gregorywright/printer-stand/SHOPPING.md

# Shopping List — Parts & Consumables

Everything that gets *consumed* by the build — steel, hardware, paint,
fasteners. Tools and PPE are in `TOOLS.md`.

The two SCAD variants share most of this list. The only difference is
the back bracing:
- **Cable-X variant** (`printer_stand.scad`) uses tensioned aircraft cable
- **Z-back variant** (`printer_stand_zback.scad`) uses two welded tube
  diagonals, which come out of the same tube stock as the rest of the frame

So the **steel order is the same for both variants** (3 sticks of tube
covers either one). Only the cable hardware differs.

Items checked are already on hand or already ordered.

---

## Steel stock (both variants)

- [ ] **1.5"×1.5"×0.120" wall A500 square tube** — buy **3× 20-ft sticks** (~60 ft)
  - Used on: legs, end-frame horizontals, end-frame diagonals, long stretchers, plus the back-panel diagonals on the Z-back variant
  - ~52.4 ft used, rest is waste/practice margin
- [ ] **3/4"×3/4"×1/8" mild steel angle** — buy **1× 20-ft stick** (~20 ft)
  - Used on: 4 angle-iron ledgers, 39.875" each (~13.3 ft used)
- [ ] **1.5"-wide × 3/8" flat bar** — buy **7 ft**
  - Cut to 5" lengths for plate A (12 plates = 5 ft), plus 4 × 1.5" foot-cap
    plates for the leg ends (~6") — buying 7 ft covers both with margin
  - Tip: buy *flat bar* in the exact width you need. Way cheaper than
    cutting plates out of sheet.
- [ ] **1.5"-wide × 3/16" flat bar** — buy **6 ft**
  - Cut to 5" lengths for plate B (12 plates needed)

**Where to buy:** Pacific Industrial Supply (Seattle — weekday pickup only).
Sold by the pound; full-length sticks. **Avoid Home Depot / Metals Depot /
eBay** — typically 50–100% more expensive on tube.

**Pricing (Pacific Industrial Supply):**

| Stock | $/lb | $/ft | Buy | Cost |
|---|---|---|---|---|
| 1.5×1.5×0.120 tube (2.25 lb/ft) | $2.30 | $5.18 | 60 ft (3×20') | **$311** |
| 3/4×3/4×1/8 angle (0.58 lb/ft) | ~$2.30¹ | ~$1.35¹ | 20 ft (1×20') | **~$27**¹ |
| 1.5"×3/8" flat bar (1.92 lb/ft) | $1.75 | $3.36 | 7 ft | **$23** |
| 1.5"×3/16" flat bar (0.96 lb/ft) | $1.75 | $1.68 | 6 ft | **$10** |
| **Steel subtotal** | | | | **~$371** |

¹ Angle iron price not yet confirmed — estimated at the same $/lb as tube.

---

## Practice stock (skills warm-up — NOT part of the build)

Grab these as cheap **drops/remnants** (sold by the pound) on the same steel-
yard trip, to practice welding, cutting, and tapping before you touch the
real sticks. Skill-building only — we are **not** switching the build to
thinner tube (see `DESIGN.md`).

- [ ] **1.5"×1.5"×0.120" tube** — ~8–12 ft of drops. Cut into ~4–6" coupons
  for 90° corner/T joints and **45° miters**, and to dial in heat on your
  REAL wall thickness (the key burn-through calibration).
- [ ] **14ga square tube** (~0.065–0.083" wall) — ~6 ft. "Hard mode" heat
  control: if you can weld this without blowing through, 0.120" feels easy.
  Practice only; confirm the actual wall when buying.
- [ ] **3/8" flat bar, 1.5" wide** — ~2 ft. Tap **3/8"-16** (plate A) and
  **M12×1.75** (foot-cap), and practice the **3/8"-plate-to-tube fillet** (the
  hardest real weld) + capping a tube end. Buy extra so you can afford to
  break a tap.
- [ ] **3/16" flat bar, 1.5" wide** — ~1.5 ft. Drill 7/16" clearance holes;
  weld plate B to a tube END; cut + **edge-weld a cable-anchor tab** and drill
  its hole.
- [x] **3/4"×3/4"×1/8" angle** — already have ~3 ft. Practice welding thin
  angle to tube + drilling the shelf-screw holes.

**At the yard:** use the drop rack; bring a **magnet** (mild steel only —
skip galvanized/painted/oily); match the build wall (**0.120"**) for the
calibration coupons. Already on hand: taps (metric + imperial), tap drills,
and cutting fluid.

---

## Welding consumables (both variants)

- [ ] **Flux-core wire**, E71T-11, 0.030" diameter, **2-lb spool**
  - 10-lb spool is more economical if you'll do future projects
- [x] Anti-spatter nozzle dip (already have)
- [ ] Anti-spatter spray (different product — protects the workpiece;
  optional, makes cleanup faster but not required)

---

## Hardware — flange-plate joints (both variants)

- [ ] **3/8"-16 × 1" hex bolts**, qty **30** (24 needed + spares)
  - Grade 5 zinc-plated *or* 18-8 stainless are both fine. Stainless
    looks cleaner and won't rust; grade 5 is a touch stronger if it
    matters (it doesn't, here).
  - If using stainless: lubricate threads on assembly to prevent galling
- [ ] **3/8" flat washers**, qty 30 — one per bolt under the head

---

## Hardware — leveling feet (both variants)

- [x] **M12×1.75 swivel leveling feet**, 2" (50mm) rubber base, 50mm stud,
  qty **4** (Luomorgo or similar). Rubber/nylon base doubles as the floor
  pad. Confirm pitch is **M12×1.75** (coarse) so a standard M12 tap fits.
- [ ] **Make your own foot-cap plates**: 4 × 1.5"×1.5"×3/8" steel squares,
  welded onto the leg ends (cap), then tapped M12×1.75 for the leveler studs
  - Cut from the 3/8" flat-bar offcut (see Steel stock) — no extra material
  - **M12×1.75 tap + ~10.2mm (13/32") drill** does the tapping (tool — see `TOOLS.md`)

---

## Hardware — wood top mounting (both variants)

- [ ] **3/8"-16 threaded inserts for wood** (E-Z Lok or knife-thread), qty **4–8**
- [ ] **3/8"-16 × 1" pan-head machine screws**, qty 4–8 (match insert count)
- [ ] **1" fender washers**, qty 4–8 — big OD to span the slotted holes

---

## Back bracing — open-back build (current plan)

The current plan builds the back **open** (no cable X, no Z-tube) and adds
the cable X later *only if* post-build testing shows wobble (see `DESIGN.md`).
That splits this into two buys: the **anchors** (made/welded now, part of the
base build) and the **cable chain** (deferred).

### Anchors — fabricate & weld during initial build

- [ ] **4 cable anchors** on the rear corner legs. Either:
  - **DIY (≈$0):** cut from the 3/16" flat-bar offcut, ~3/4–1" wide, drill a
    hole for a 1/4" shackle pin, **edge-weld so the hole stands clear of the
    tube** (a hole in a tab laid flat against the tube is blocked). OR
  - **Buy (~$10–20):** weld-on pad eye or weld-on D-ring (search "weld on pad
    eye" or "weld on D ring tie down"), qty 4. Trailer-rated ones are wildly
    overkill; grind off any zinc plating before flux-core welding.
- Load is trivial — size for looks/weldability, not strength. No swivel
  needed (the shackle articulates). **Weld these on *before* paint/powder**
  so adding cables later needs no welding.

### Cable chain — deferred (buy only if testing shows wobble)

Skip unless/until you decide to install the X-wing.

- [ ] **1/8" stainless 7×19 aircraft cable**, ~12 ft (two diagonals + overhead)
- [ ] **Cable eye terminals**, stainless, qty **4** — mechanical/swageless
  (e.g. Hayn Hi-MOD, no swage tool needed) or swaged eyes
- [ ] **Stainless turnbuckles**, jaw-and-jaw, 1/4" stock, qty **2**
- [ ] **Stainless shackles**, ~1/4" pin, qty **2** — connect each cable's
  non-turnbuckle end to its anchor
- [ ] *(Optional)* cable cutter — borrow if possible (see `TOOLS.md`)

**Deferred cable-chain subtotal:** ~$80–$120

---

## Z-back variant ONLY (`printer_stand_zback.scad`)

**No additional parts.** The two back-panel diagonals come out of the
3 sticks of tube already counted above. This variant is ~$80–$120 cheaper
than the cable variant (no cable hardware to buy).

---

## Finishing (both variants)

Pick one path:

**DIY rattle-can** (~$50)
- [ ] Acetone or denatured alcohol (degrease before painting)
- [ ] Self-etching primer for steel, 1 can
- [ ] Matte/satin black enamel top coat, 2–3 cans

**Powder coat** (~$100–200, recommended for durability)
- [ ] Drop the disassembled frame at a local powder coater. Disassemble
  first — the powder coater bakes the parts in an oven and they need to
  fit in racks.

---

## Floor protection (both variants)

- Not needed — the M12 leveling feet have rubber/nylon bases that protect
  the tile and resist creep. (Add felt pads only if you switch to bare-steel feet.)

---

## Cost rollup

| Category | Cost |
|---|---|
| Steel stock (Pacific Industrial) | ~$371 |
| Welding consumables | ~$15 |
| Bolts + washers | ~$15 |
| Levelers + M12 tap | ~$40 |
| Wood-top mounting hardware | ~$10 |
| Back-brace anchors (welded at fab) | ~$0–20 |
| Finishing (DIY rattle-can) | ~$50 |
| Floor pads | $0 (rubber-base feet) |
| **Base build (open back)** | **~$500** |
| Cable X chain (*deferred* add-on, only if needed) | +$80–$120 |

If powder-coating instead of rattle-can, add ~$100.

---

## Wood (you have this)

- [x] Hardwood for the top, ~48"×25.75"×**1-3/16"** (matches the adjacent
  counter). Red oak / white oak / hard maple — hard enough not to dent in
  light bench use. Plane to final thickness after measuring the built frame.
- [x] Plywood for the two shelves: cut to fit after the frame is built
  (from one 4'×8' sheet of 3/4" plywood)
