gregorywright/printer-stand/(list of files, cad)

Other CAD files:
printer_stand_zback.scad
