gregorywright/printer-stand/(commit log)

2026-05-25 Initial design: knockdown steel + wood 3D printer stand
    OpenSCAD model plus design docs for a welded-steel-frame, bolt-together
    3D printer stand sized to match an adjacent kitchen counter (37" tall,
    48"x25.75" top). Uses two welded end frames, six bolted long stretchers
    with flange-plate joints, internal end-frame diagonals, top knee braces,
    and a tensioned cable X across the back.
    [printer_stand.scad]
2026-05-25 Refine flange plate geometry and shelf heights
    Replace 3"x3" flange plates with tall narrow columns (1.5"W x 6"H) aligned
    with leg face — no Y-axis protrusion, ~2x moment resistance for shelf loads.
    Plates are asymmetric: 3/8" tapped plate A on the leg, 3/16" clearance
    plate B on the stretcher end. Bolts thread directly into plate A; no
    separate nuts.
    Raise middle shelf to 23.75" for 10" upper-bay clearance and 17.25" lower-bay
    clearance (fits 8" filament spools standing up). Lower-bay diagonal now runs
    at ~42.6°.
    Resolve knee-brace knockdown problem: braces weld between plate B's lower
    extension and stretcher tube underside, traveling with the stretcher
    assembly.
    [printer_stand.scad]
2026-05-25 Simplify joints to 2 bolts, add angle-iron shelf ledgers, fix knee brace
    Drop bolts per joint from 4 to 2 (24 bolts total instead of 48). Originally
    overbuilt by ~50x; 2 bolts at +/-1.75" from stretcher centerline still gives
    huge margin and resolves the bolt-tube collision on middle/bottom plates.
    Differentiate plate heights by stretcher position. Top stretchers need 7.5"
    to fit tube + 2 bolts + knee brace with socket-wrench clearance. Middle/
    bottom need only 5" (tube centered, one bolt above and below).
    Render knee braces with proper mitered cuts: outboard end vertical (flush
    to plate B), inboard end horizontal (flush to stretcher underside).
    Add 3/4"x3/4"x1/8" angle-iron ledgers welde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
    [printer_stand.scad]
2026-05-25 Fix knee brace orientation and top-stretcher bolt placement
    Knee braces were rendered in the wrong plane: polygon() lives in XY but the
    brace silhouette uses XZ coordinates, so the Z values got interpreted as Y
    and the braces floated 30" behind the stand. Add rotate([90,0,0]) before
    linear_extrude so the polygon's Y axis maps to world Z.
    Top-stretcher bolts: previous symmetric bolt placement put one bolt at
    z=36.25" -- inside the wood top, hidden. Both top-stretcher bolts now sit
    below the tube (z=33.0 and z=31.5), in the gap between tube bottom and
    knee-brace top, with 1.5" socket clearance. Middle/bottom stretchers still
    straddle the tube symmetrically.
    [printer_stand.scad]
2026-05-25 Drop knee braces, unify plate height to 5"
    Knee braces were structurally redundant given welded rectangular corners,
    end-frame diagonals, cable X, and the moment resistance of the 2-bolt
    flange joints (1.5" lever arm between top-joint bolts gives ~50:1 safety
    factor against top-joint racking). Removing them simplifies fabrication
    and lets every flange plate be the same size.
    All 12 plates now 1.5"x5" (was 7.5" for top stretchers, 5" for others).
    Top-stretcher plates still have their tube at the top edge with both bolts
    below; middle/bottom plates still center on the stretcher with one bolt
    above and one below. No change to bolt count, ledgers, cable X, or
    end-frame geometry.
    [printer_stand.scad]
2026-05-25 Add Z-tube back-panel variant alongside cable-X version
    New printer_stand_zback.scad: identical to printer_stand.scad except the
    cable X on the back is replaced by two welded tube diagonals in a Z
    pattern (upper-bay slope \, lower-bay slope /). The three back-stretchers
    plus two diagonals form a pre-welded "back panel" that bolts to the legs
    through the existing six plate-pair joints. No cable hardware required.
    Owner is keeping both designs to compare visually before picking. Update
    AGENTS.md to require future upstream changes (legs, end frames, stretchers,
    plates, ledgers, shelves, top) to be applied to BOTH SCAD files. Note the
    variant in DESIGN.md.
    [printer_stand_zback.scad]
2026-05-25 Add tools and supplies catalog
    New TOOLS.md catalogs everything needed for the build with checkboxes:
    welding, cutting/grinding, drilling/tapping, measuring, hand tools,
    woodworking, steel stock, hardware, wood-top mounting, cable hardware
    (cable-X variant only), finishing, floor protection, PPE.
    Items the owner already has are checked. Unchecked items are still on
    the shopping list. Approximate cost rollup for the unchecked items at
    the bottom (~$1,000-1,400 if starting from nothing).
    Reference TOOLS.md from AGENTS.md.
2026-05-26 Split parts/consumables out of TOOLS.md into SHOPPING.md
    New SHOPPING.md catalogs everything that gets consumed by the build
    (steel stock, welding consumables, hardware, finishing, floor pads),
    broken out by variant. Steel order is identical for both variants;
    only the cable hardware differs. Includes cost rollup: cable-X variant
    ~$455-$655, Z-back variant ~$375-$535.
    TOOLS.md now scoped to tools and PPE only -- the parts duplications
    removed.
2026-05-28 Remove fabricated McMaster part numbers
    The "McMaster 2417K3" and "McMaster 91833A132" part numbers in SHOPPING.md
    were not real -- they were invented as plausible-looking placeholders.
    Replaced with actual search instructions (category names + filter criteria)
    plus an Amazon alternative for each, and a note distinguishing weld-in
    inserts from rivnuts.
2026-05-31 Design update: 45° end-frame diagonal, split overhangs, 1-3/16" wood top, tapped foot-cap feet
    - End-frame diagonal: true 45°, single-miter, back-top to front-bottom
    (modeled as a real mitered solid, not a square-cut tube_between)
    - Overhangs split into independent sides (OVERHANG_LR) and front/back
    (OVERHANG_FB), both default 2"
    - Wood top thickness -> 1-3/16" (matches counter); steel top now 35.8125";
    wood top re-added to the SCAD render (plywood shelves still not modeled,
    ledgers kept)
    - Leveler feet: tapped 3/8" foot-cap plate (1/2"-13) welded on leg ends,
    replacing the weld-in insert; legs cut long and trimmed to fit; nominal
    lift set mid-range (~1") for two-way error take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
    [printer_stand.scad, printer_stand_zback.scad]
2026-05-31 Moved to metric, M12, leveling feet
    [printer_stand.scad, printer_stand_zback.scad]
2026-06-01 Add weld-on cable anchors + wood-top hold-downs; defer rear cable X
    Design decision: build the back open (no cable X / Z-tube), keep the
    end-frame diagonals, test, and add the cable X later only if it wobbles.
    Weld the 4 cable anchors at fabrication so adding cables later is a
    no-welding bolt-on job.
    SCAD (both files kept in sync upstream of the back face):
    - Model wood-top hold-down clips on the top stretchers (front-center =
    fixed round-hole anchor, rest Y-slotted) + fender washer/screw.
    - printer_stand.scad: add 4 weld-on cable anchors (always shown); route
    cable X to the anchor holes; add SHOW_CABLES toggle (cables deferred)
    and SHOW_WOOD_MOUNTS.
    - Cut lists updated.
    Docs: SPECS/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
    [printer_stand.scad, printer_stand_zback.scad]
2026-06-01 Fix angle-ledger placement (was buried in tube); add per-part colors
    - angle_ledger: corrected so the angle sits on the inboard top edge and
    projects inward (was computing the outboard face and landing the legs
    fully inside the stretcher tube -> invisible on F6). Verified visible
    via OpenSCAD render.
    - Colors: square tube stays steel-grey; every non-tube part now has its
    own contrasting color (plate A blue, plate B amber, ledgers green,
    wood clips purple, cable anchors red) so joints read clearly.
    - Both files render manifold, NoError.
    [printer_stand.scad, printer_stand_zback.scad]
2026-06-01 Correct wood-movement spec: Seattle swing + fix too-short slot length
    - DESIGN.md: add the cross-grain movement calc (species table @ ΔMC 4),
    note Seattle's small ~ΔMC 3-4 indoor swing (~1/4-3/8" full-width oak),
    fix the slot spec (was "~3/8 long" = ~zero travel) to ~15/16" matching
    the SCAD model, and correct the anchor description (front-anchored top
    floats toward the back, not symmetric).
    - SPECS.md: update the wood-movement constraint with the Seattle estimate
    and a pointer to the calc.
2026-06-01 Inset shelf ledgers by plywood thickness; screw-down hold-down
    - angle_ledger: recess the support leg DOWN by the plywood thickness
    (PLY_THK = 23/32") so the plywood TOP finishes flush with the stretcher
    tube top (was flush AT the top, leaving the ply proud). Add wood-screw
    clearance holes through the horizontal leg every ~6" (SHELF_SCREW_PITCH)
    -- plywood is dimensionally stable so round holes, no slots. Ledgers stay
    full-length. Both SCAD files in sync; render manifold NoError.
    - Docs (SPECS/DESIGN/AGENTS): ledger inset, full-length span, and screwed-
    down (not gravity-held) plywood.
    [printer_stand.scad, printer_stand_zback.scad]
2026-06-01 SHOPPING: add practice-stock section (welding/tapping warm-up)
    Skill-building scraps for the steel-yard trip: 0.120" tube coupons,
    14ga tube (heat-control practice only, not a build switch), 3/8" and
    3/16" flat bar for tap/fillet practice; notes the 1/8" angle already on
    hand and the yard tips (drop rack, magnet, no galvanized).
2026-06-02 Model the welded leg-end foot-cap plate at each foot
    - Draw the 1.5x1.5x3/8 foot-cap (FOOTCAP_THK, teal) between the leg-tube
    bottom and the leveler stud, and trim the stud to the cap underside (it
    was drawn through the cap's space). The cap's 3/8 was already inside the
    1.75 LEVELER_HT lift, so total height is unchanged.
    - DESIGN.md: make the foot-cap explicit in the nominal-lift stack.
    - Both SCAD files in sync; render manifold NoError.
    [printer_stand.scad, printer_stand_zback.scad]
2026-06-02 Record out-of-level floor; level with feet only (keep end-frames identical)
    Floor drops ~1/2" over the 48" width (~0.44" across the 42.5" foot span).
    Handled entirely by the adjustable leveler feet (only ~0.22" centered, well
    within travel). Do NOT trim legs to a floor's slope: the stand is knockdown
    and relocatable, and the end-frames are built identical -- re-level the feet
    at each location. No SCAD change.
2026-06-02 Set leveler nominal to 2.0" (cap stacks above leveler); leg -> 33.4375"
    Real foot measures 42-72mm (floor->cap underside) and the install floor
    slopes ~1/2" down away from the counter, so the far feet ride ~1/2" higher
    than the counter feet (a fixed offset). Center that foot PAIR in the range:
    counter-end foot ~2.0", far-end ~2.5", leaving ~+/-0.34" build slack and
    keeping the far foot under the 72mm max. (2.25" range-center would top out
    the far foot.)
    - SCAD (both): LEVELER_HT 1.75->2.0 (= leveler hardware only, floor->cap
    underside); LEG_BOTTOM_Z = LEVELER_HT + FOOTCAP_THK (cap stacks ABOVE the
    leveler); LEG_HT recomputes to 33.4375"; comments + cut list updated.
    Total height uncha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
    [printer_stand.scad, printer_stand_zback.scad]
2026-06-02 Update SHOPPING.md with Pacific Industrial Supply pricing
    - Add actual $/lb rates: tube .30/lb, flat bar .75/lb
    - Calculate per-foot costs and line-item totals
    - Angle iron estimated with footnote (not yet confirmed)
    - Simplify cost rollup to single column (~00 base build)
2026-06-08 Add EXTRUSIONS.md and FABRICATION.md; index in AGENTS.md
    - EXTRUSIONS.md: pros/cons catalog of a T-slot aluminum (4040/4080)
    alternative, with a how-it-works primer and a calculated check showing the
    A1 bed (~2-5 lbf) is well below the fastener slip threshold (won't loosen
    T-nuts) — corrects an earlier overstated claim.
    - FABRICATION.md: build/bench guide — flat reference surface, wooden
    end-frame jig (+ owner's magnetic squares), 3-faces-then-flip weld access,
    balanced skip-weld sequence, clamp-force reality (~100 lbf positioning, not
    restraint), welding-near-wood precautions, and 9-step build order.
    - AGENTS.md: index both new files.
2026-06-10 Add PRACTICE.md: scrap inventory and welding exercises
2026-06-18 Add standing-desk buy-now option; document sit-at-it desk variant
    Add STANDING-DESK.md covering the electric standing desk alternative
    (FlexiSpot E7 vs E7 Pro, DIY-top mounting and wood movement, how the top
    contributes to racking stability) as a buy-now stopgap and full-scale
    ergonomics mockup.
    Add a 'Using the stand as a desk' section to DESIGN.md capturing the
    off-center knee hole at the counter-seam end, the front-middle stretcher
    as the real leg blocker, seam/edge-profile matching, and the depth note.
    Index the new file and flag the dual-duty idea in AGENTS.md.
2026-06-18 Add top upgrade path to STANDING-DESK.md
    Document buy-cheap-upgrade-later strategy: top is decoupled from the frame
    (~20-min swap), do the wobble test at 37" first, and the preferred upgrade
    is two laminated 3/4" plywood sheets + edge-banding (stiffer diaphragm, no
    wood-movement issue, carries the seam roundover). Include lamination
    watch-outs.
